ahaan001/RedRobotHackathon2026-TeamUncertainty/cad/out/contact_sheet.png

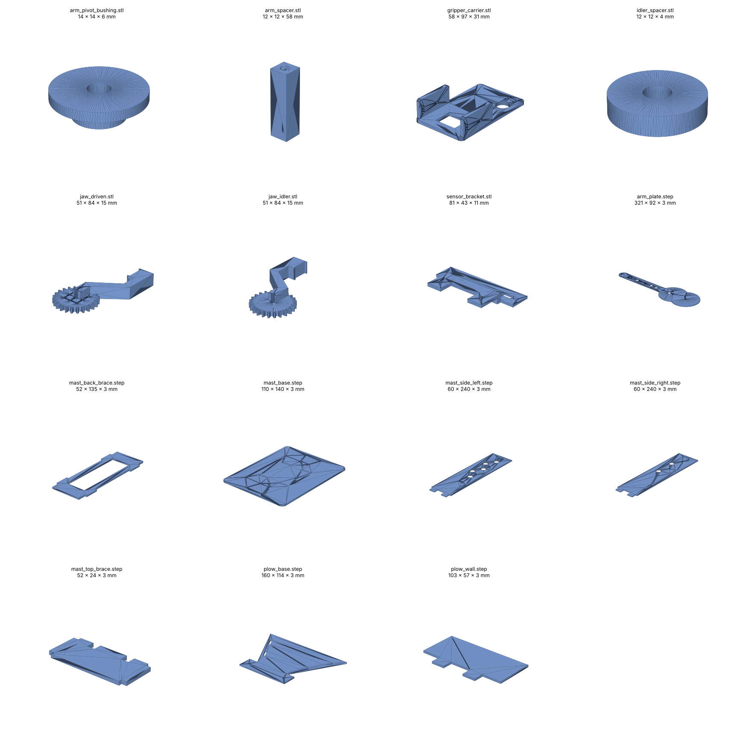
cad/out/contact_sheet.png
