ahaan001/RedRobotHackathon2026-TeamUncertainty/cad/out/printed_parts_check.png

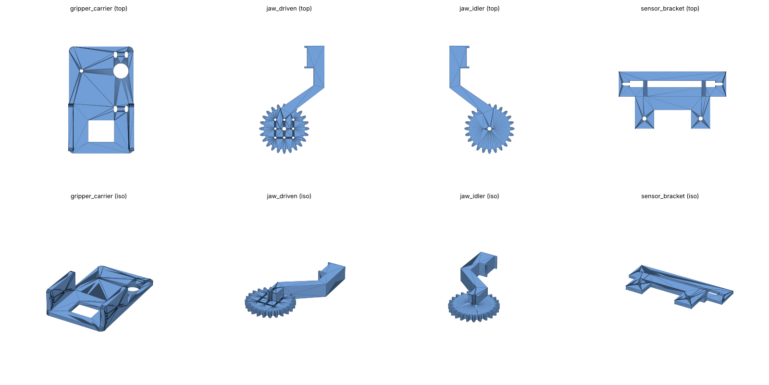
cad/out/printed_parts_check.png
