ahaan001/RedRobotHackathon2026-TeamUncertainty/cad/out/assembly_place_on_1.step

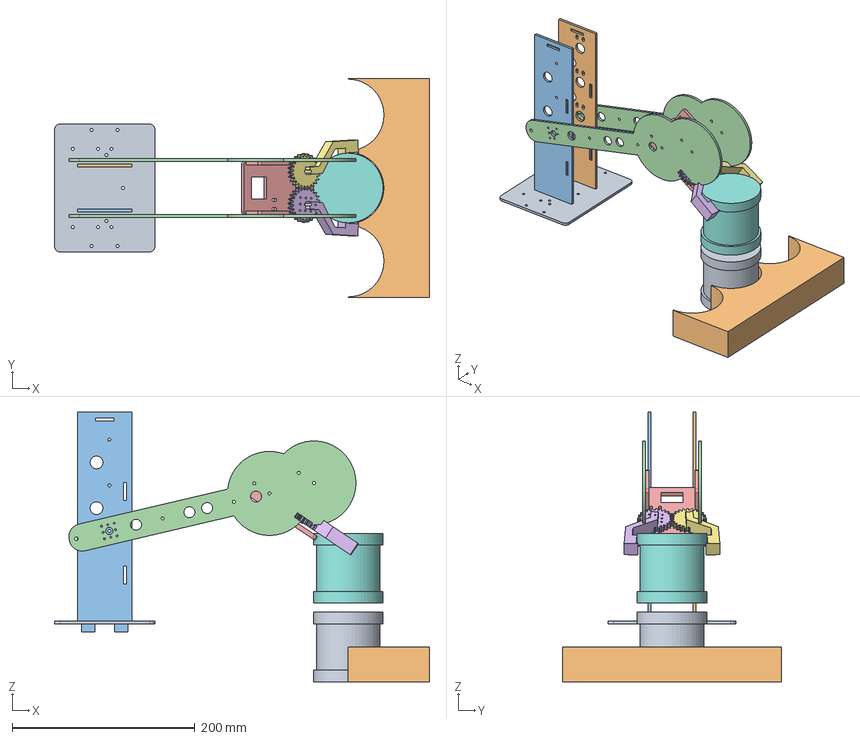
[picture p3: CAD file, 2026-11-07]
cad/out/assembly_place_on_1.step
410.4 x 240.0 x 295.0 mm
