ahaan001/RedRobotHackathon2026-TeamUncertainty/cad/out/arm_plate.step

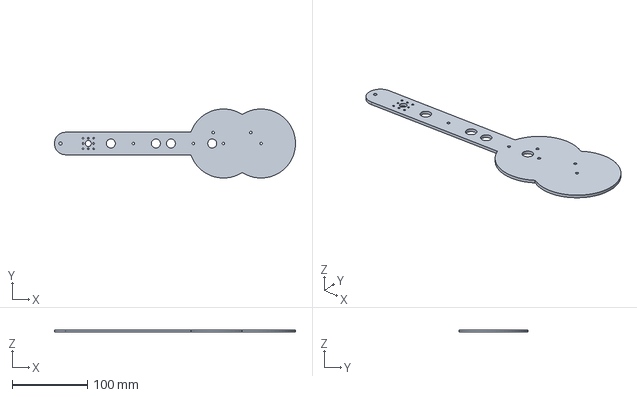
[picture p4: CAD file, 2026-11-07]
cad/out/arm_plate.step
320.9 x 92.0 x 3.20 mm
