ahaan001/RedRobotHackathon2026-TeamUncertainty/cad/out/plow_wall.step

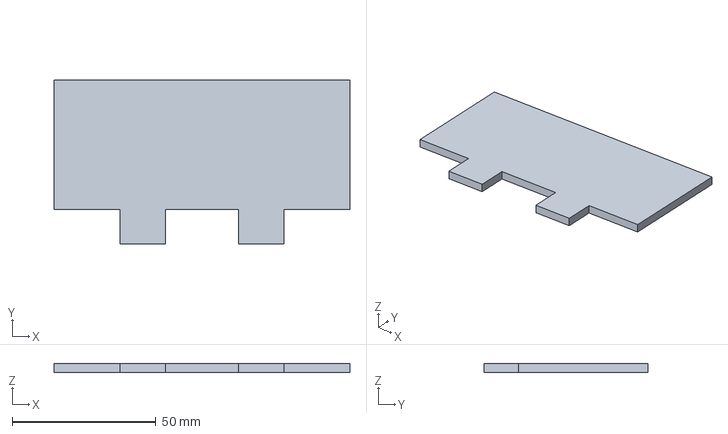
[picture p5: CAD file, 2026-11-07]
cad/out/plow_wall.step
103.0 x 57.0 x 3.20 mm
