ahaan001/RedRobotHackathon2026-TeamUncertainty/cad/out/gripper_carrier.step

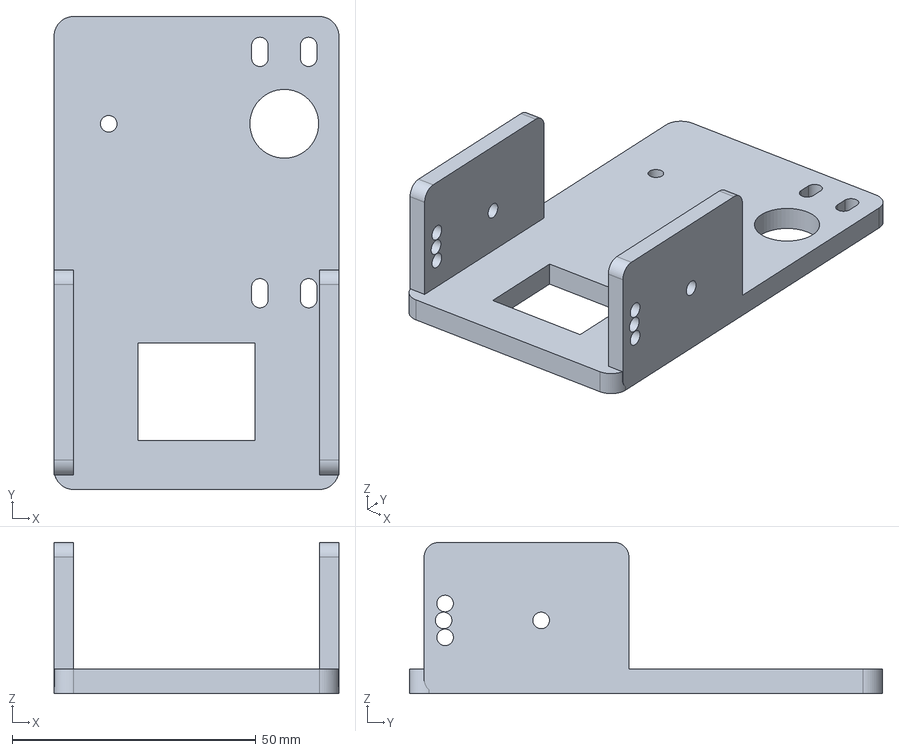
[picture p6: CAD file, 2026-11-07]
cad/out/gripper_carrier.step
58.4 x 97.0 x 31.0 mm
