ahaan001/RedRobotHackathon2026-TeamUncertainty/cad/out/mast_top_brace.step

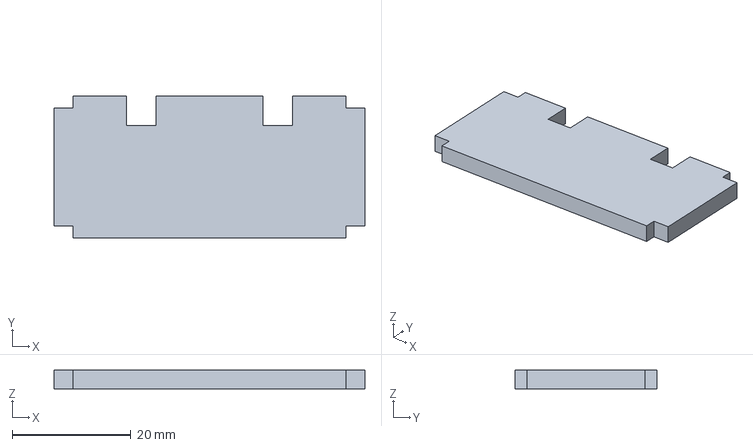
[picture p7: CAD file, 2026-11-07]
cad/out/mast_top_brace.step
52.4 x 24.0 x 3.20 mm
