ahaan001/RedRobotHackathon2026-TeamUncertainty/cad/out/mast_base.step

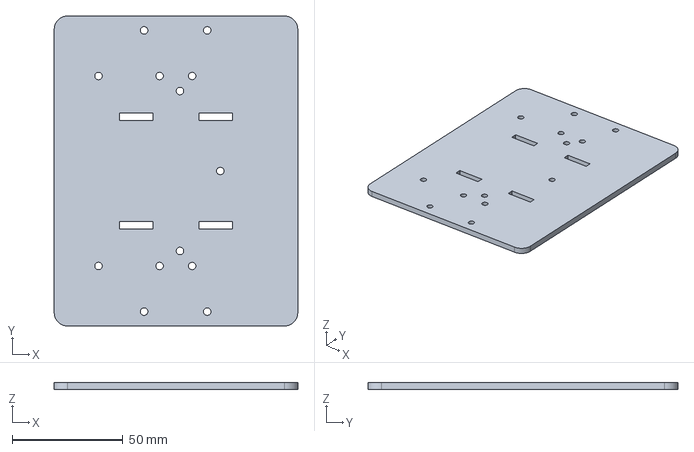
[picture p8: CAD file, 2026-11-07]
cad/out/mast_base.step
110.0 x 140.0 x 3.20 mm
