ahaan001/RedRobotHackathon2026-TeamUncertainty/cad/out/idler_spacer.step

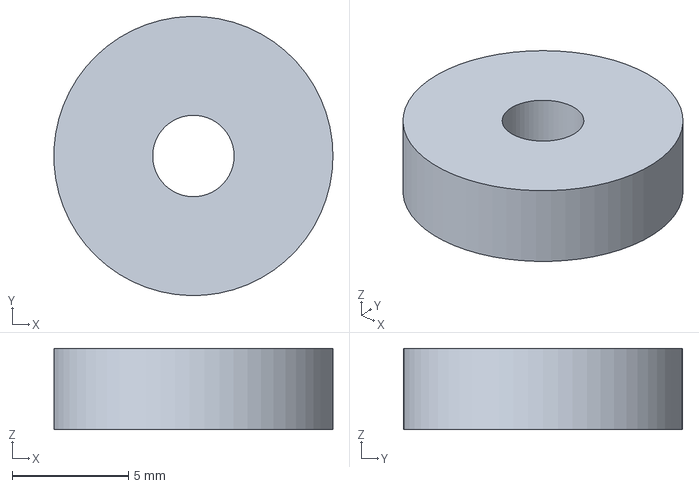
[picture p9: CAD file, 2026-11-07]
cad/out/idler_spacer.step
12.0 x 12.0 x 3.50 mm
