ahaan001/RedRobotHackathon2026-TeamUncertainty/cad/out/jaw_idler.step

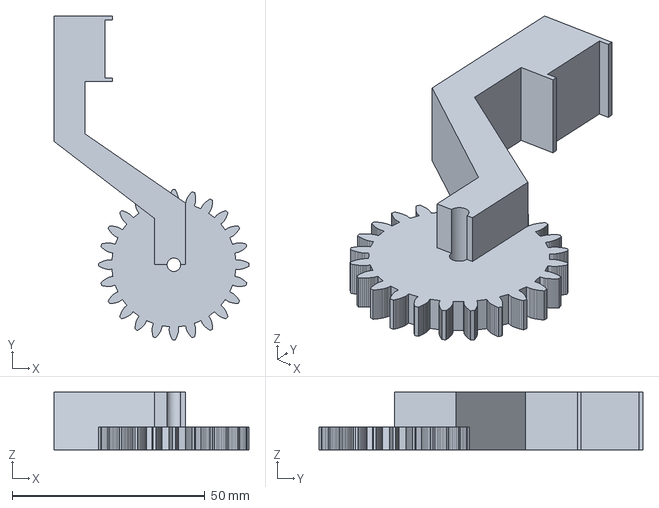
[picture p10: CAD file, 2026-11-07]
cad/out/jaw_idler.step
50.6 x 84.0 x 15.0 mm
