ahaan001/RedRobotHackathon2026-TeamUncertainty/cad/out/mast_side_right.step

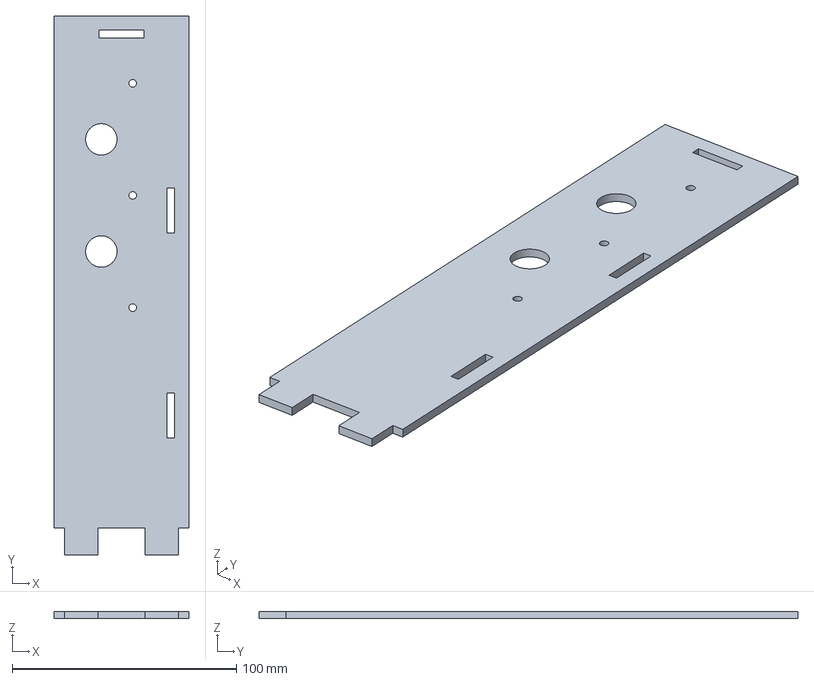
[picture p11: CAD file, 2026-11-07]
cad/out/mast_side_right.step
60.0 x 240.3 x 3.20 mm
