ahaan001/RedRobotHackathon2026-TeamUncertainty/cad/out/jaw_driven.step

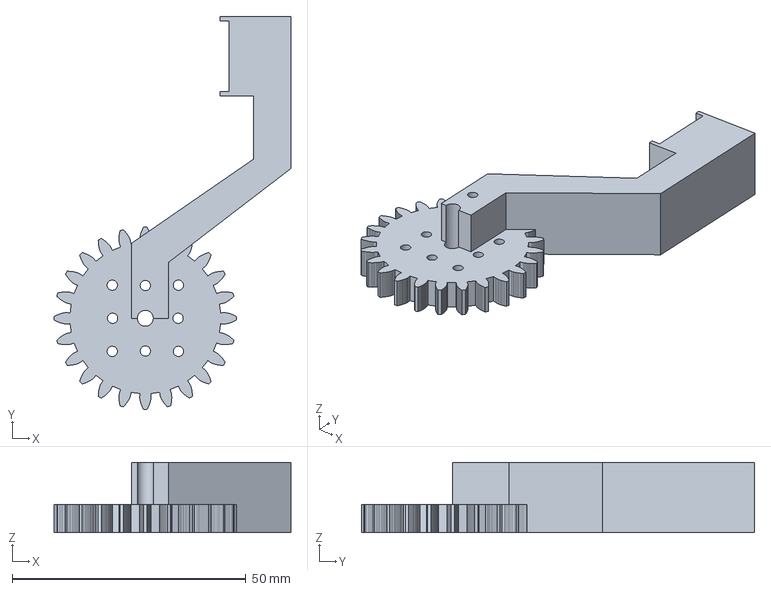
[picture p12: CAD file, 2026-11-07]
cad/out/jaw_driven.step
50.6 x 84.0 x 15.0 mm
