ahaan001/RedRobotHackathon2026-TeamUncertainty/cad/out/mast_back_brace.step

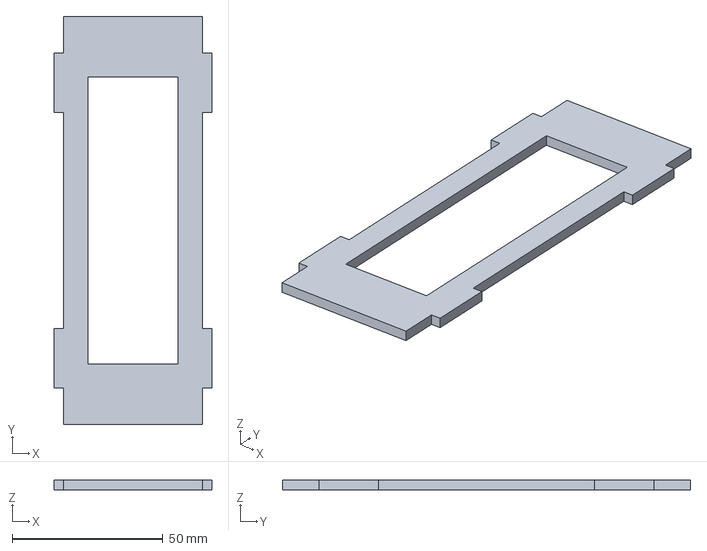
[picture p14: CAD file, 2026-11-07]
cad/out/mast_back_brace.step
52.4 x 135.3 x 3.20 mm
