ahaan001/RedRobotHackathon2026-TeamUncertainty/cad/out/plow_base.step

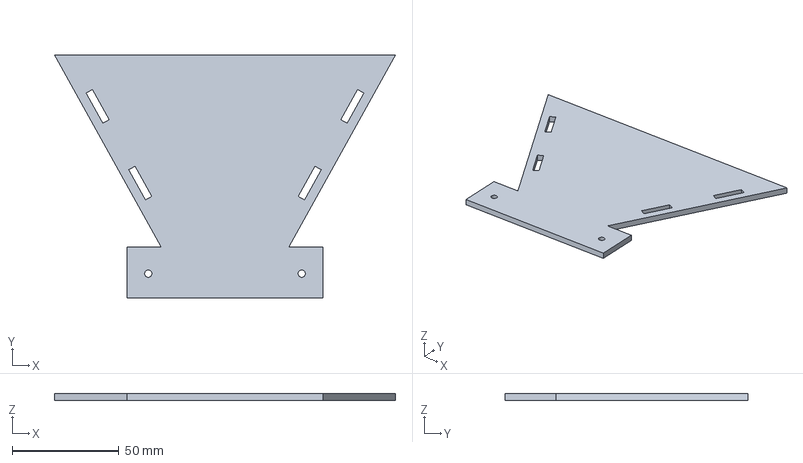
[picture p15: CAD file, 2026-11-07]
cad/out/plow_base.step
160.0 x 114.0 x 3.20 mm
