ahaan001/RedRobotHackathon2026-TeamUncertainty/cad/out/sensor_bracket.step

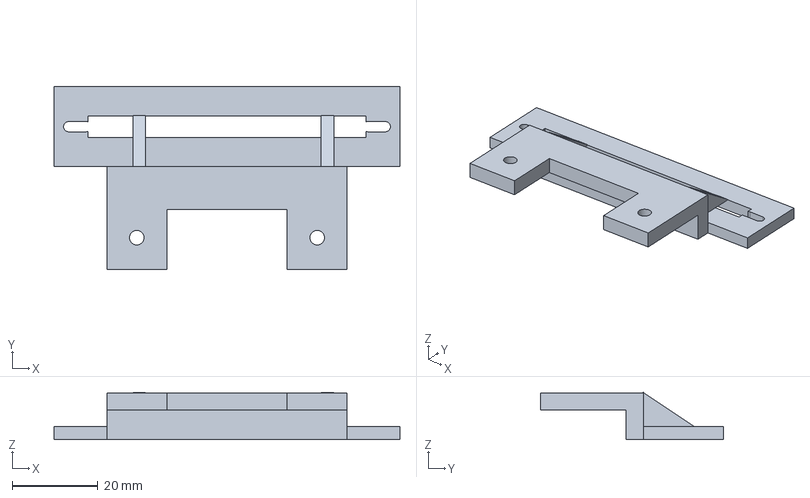
[picture p16: CAD file, 2026-11-07]
cad/out/sensor_bracket.step
80.9 x 42.7 x 11.0 mm
