ahaan001/RedRobotHackathon2026-TeamUncertainty/cad/out/arm_spacer.stl

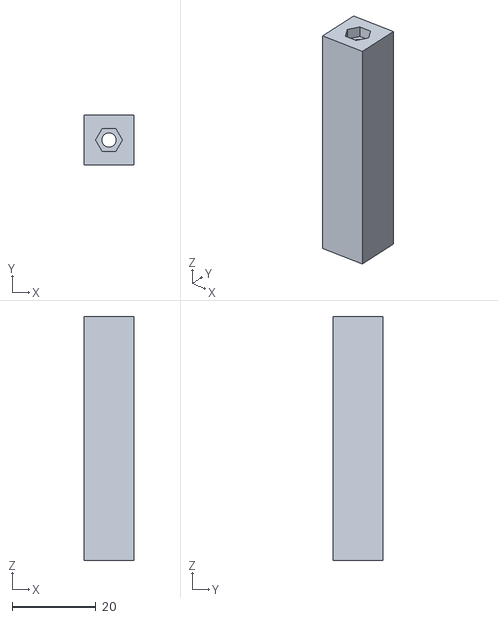
[picture p17: CAD file, 2026-11-07]
cad/out/arm_spacer.stl
12.0 x 12.0 x 58.4
