ahaan001/RedRobotHackathon2026-TeamUncertainty/cad/out/arm_pivot_bushing.stl

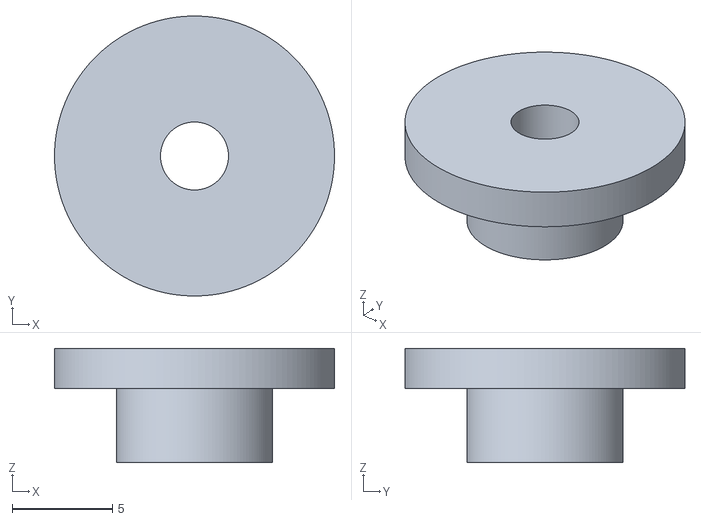
[picture p18: CAD file, 2026-11-07]
cad/out/arm_pivot_bushing.stl
14.0 x 14.0 x 5.70
