ahaan001/RedRobotHackathon2026-TeamUncertainty/(list of files, cad)

Other CAD files:
cad/out/arm_plate.dxf
cad/out/gripper_carrier.stl
cad/out/idler_spacer.stl
cad/out/jaw_driven.stl
cad/out/jaw_idler.stl
cad/out/mast_back_brace.dxf
cad/out/mast_base.dxf
cad/out/mast_side_left.dxf
cad/out/mast_side_right.dxf
cad/out/mast_top_brace.dxf
cad/out/plow_base.dxf
cad/out/plow_wall.dxf
cad/out/sensor_bracket.stl
