ahaan001/RedRobotHackathon2026-TeamUncertainty/cad/out/assembly_check.png

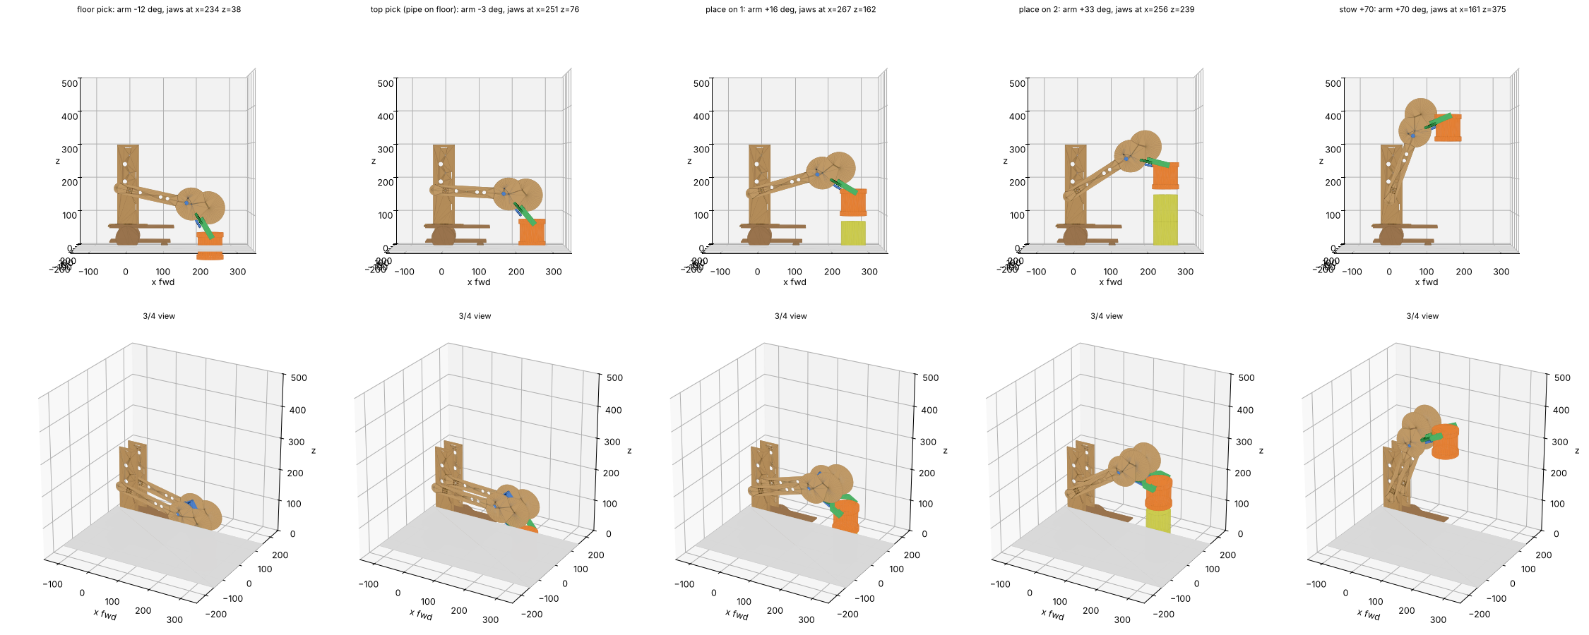
cad/out/assembly_check.png
