ahaan001/RedRobotHackathon2026-TeamUncertainty/docs/TESTLOG.md

# Test log

One line per test. Add at the top. A failure seen twice gets a task; three times stops the feature until fixed.

| Time | FW tag | Attempted | Result | Suspected cause | Owner |
| --- | --- | --- | --- | --- | --- |
| | | | | | |

## Measurements

| Item | Value | Unit | Measured by | Notes |
| --- | --- | --- | --- | --- |
| Pipe mass | ~200 (PLACEHOLDER) | g | | manual says 3 in × 3 in; team estimate differs, verify |
| Pipe body OD | | mm | | |
| Pipe flange OD | ~38 (PLACEHOLDER, 1.5 in) | mm | | |
| Pipe flange thickness | | mm | | |
| Pipe length | ~127 (PLACEHOLDER, 5 in) | mm | | |
| Servo label | | | | |
| Servo stall torque at 5 V | | kg·cm | | Gate 1 |
| Servo body L × W × H | | mm | | |
| Top plate W × L, height above floor | | mm | | |
| Baseplate underside height above floor | | mm | | |
| Steam Plant semicircle diameter | | mm | | |
| Tape width | | mm | | |
| Line sensor white / black | | µs | | per channel |
