ahaan001/RedRobotHackathon2026-TeamUncertainty/(commit log)

2026-11-07 tools: standalone QTR-8RC line sensor diagnostic sketch (uncompiled)
    Copies of the organizers' library files; prints six raw decay times and read duration.
    Claude-Session: https://claude.ai/code/session_0138tJnS9TAPmo4cWQMACo7T
2026-11-07 cad: parametric CadQuery parts with placeholder pipe dimensions
    sensor bracket, mast (3 pivot heights), arm plates (2 gripper hole sets), gear
    gripper with rim dimples, plow, BOM, assembly notes, reach model and assembly
    renders. Pipe: team estimate 127 mm / flange 38 mm / 200 g (manual says 3x3 in);
    regenerate with build_all.py after measurement.
    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
    [arm_pivot_bushing.stl, arm_plate.dxf, arm_plate.step, arm_spacer.stl, gripper_carrier.step, gripper_carrier.stl, idler_spacer.step, idler_spacer.stl]
2026-11-07 cad: regenerate with measured pipe (3 in flange, 2.75 in body, 0.5 in flange, 75 g) and HS-311
    Jaws redesigned as hook claws that close under the top flange (geometric lip hold,
    no dimples). Servo tab holes slotted; horn screw holes at two PCDs. Primary arm
    config now L=180 / pivot 165: floor pick -12 deg, place on 3 at +52 deg (4-stack).
    Pipe height still assumed 76.2 mm pending a ruler check.
    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
    [arm_plate.dxf, arm_plate.step, gripper_carrier.step, idler_spacer.step, jaw_driven.step, jaw_driven.stl, jaw_idler.step, jaw_idler.stl]
2026-11-07 cad: chassis from organizers' STEP; mast base matches top-plate holes (rear/front); bracket and plow on baseplate holes
    Pipe height confirmed 3 in. Top plate 63.5 mm above floor, baseplate underside 19.5 mm,
    axle at x=120.6, caster at x=17. Field notes from photos in ASSEMBLY.md.
    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
    [arm_plate.dxf, arm_plate.step, gripper_carrier.step, idler_spacer.step, jaw_driven.step, jaw_idler.step, mast_back_brace.dxf, mast_back_brace.step]
2026-11-07 cad: fix workplane origin accumulation (holes were misplaced), robust DXF export, verify_parts.py
    Every chained .faces().workplane() now uses origin=(0,0,0). DXF export writes all
    bottom-plane edges and re-reads the file. verify_parts.py checks hole positions
    against params; build_all fails if a DXF is empty. This revision is the first one
    safe to fabricate.
    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
    [arm_plate.dxf, arm_plate.step, gripper_carrier.step, gripper_carrier.stl, idler_spacer.step, jaw_driven.step, jaw_idler.step, mast_back_brace.dxf]
2026-11-07 cad: scoring-cycle simulation video and positioned STEP assembly; hook-height correction in reach model
    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
    [arm_plate.dxf, arm_plate.step, assembly_place_on_1.step]
2026-11-07 tools: bang-bang line test on L1/L3 with the InitRedRobot fix (uncompiled)
    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
    [CONFIGURE-ME.h, LineTestBangBang.ino, RedRobot.cpp, RedRobot.h, ble.h]
2026-11-08 Refactor Arduino code for improved line following
    Refactor and enhance the line following logic, motor control, and sensor handling in the Arduino code for the Red Robot 2026.
